radoslavpalenik/IMP_proj/README.md

# IMP_proj
## Projekt na predmet IMP v akad. roku 2020/21
### Hodnotenie
14/14 b.
### Zadanie
_**Zvolte vhodný model (hotový, LEGO, Merkur nebo jiná stavebnice), který bude disponovat alespoň třemi různými funkcemi/pohyby funkčních bloků (např. bagr, jeřáb, robot apod.) Předpokládám, že zapojíte svoji tvořivost, aby výsledkem byl smysluplně vyhlížející a fungující celek.**_

_**Navrhněte vhodné rozhraní pro připojení pohybových elementů k vývojovému kitu a vytvořte ovládací program, pomocí kterého bude možné interaktivně řídit všechny úkony modelu (např. pomocí příkazů zadávaných přes terminál s vhodně nastavenými parametry, případně prostřednictvím klávesnice). Dále navrhněte alespoň dvě programové sekvence, na kterých budete demonstrovat činnost modelu realizujícího posloupnost zvolených povelů (jediným příkazem model vykoná složitější úkon).**_

*Mikroprocesorové a vestavěné systémy
